newHeiko/wiFred/(notices)

Notices in the files:
hardware/User_interface_rev6.sch:
Heiko Rosemann (heiko.rosemann@web.de) CC-BY-SA
